p0lysim/VernierThrottle/hardware/3mf/Vernier_Throttle_Bambu_P2S.3mf

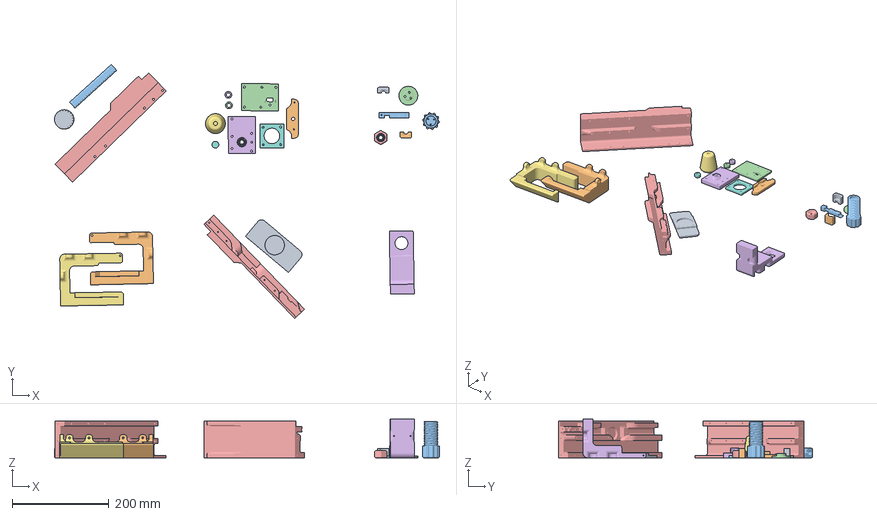
[picture p39: CAD file, 2026-11-11]
hardware/3mf/Vernier_Throttle_Bambu_P2S.3mf
794.5 x 524.5 x 79.8 mm
AS5600_Holder_P1_x1.stl
AS5600_Holder_P2_x1.stl
Arduino_Rail_x1.stl
Back_Plate_x1.stl
Bottom_Shell_x1.stl
Clamp_Center_x1.stl
Clamp_Left_x1.stl
Clamp_Pad_Cover_x1.stl
Clamp_Pad_x1.stl
Clamp_Right_x1.stl
Clamp_Screw_x1.stl
Clamp_Swivel_Disc_x1.stl
Front_Nut_x1.stl
Front_Plate_x1.stl
Knob_x1.stl
Magnet_End_Cap_x1.stl
Pinion_Gear_x1.stl
Pot_Bracket_x1.stl
Rack_Slider_x1.stl
Shaft_Collar_x2.stl x 2
Top_Shell_x1.stl
