p0lysim/VernierThrottle/hardware/stl/Pot_Bracket_x1.stl

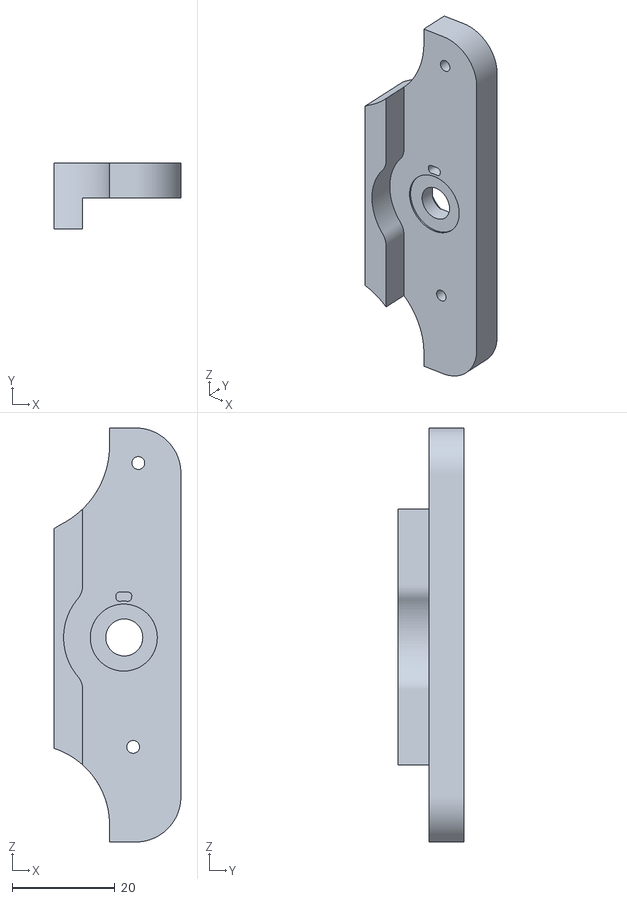
[picture p40: CAD file, 2026-11-10]
hardware/stl/Pot_Bracket_x1.stl
24.7 x 12.9 x 80.6
