p0lysim/VernierThrottle/hardware/stl/Shaft_Collar_x2.stl

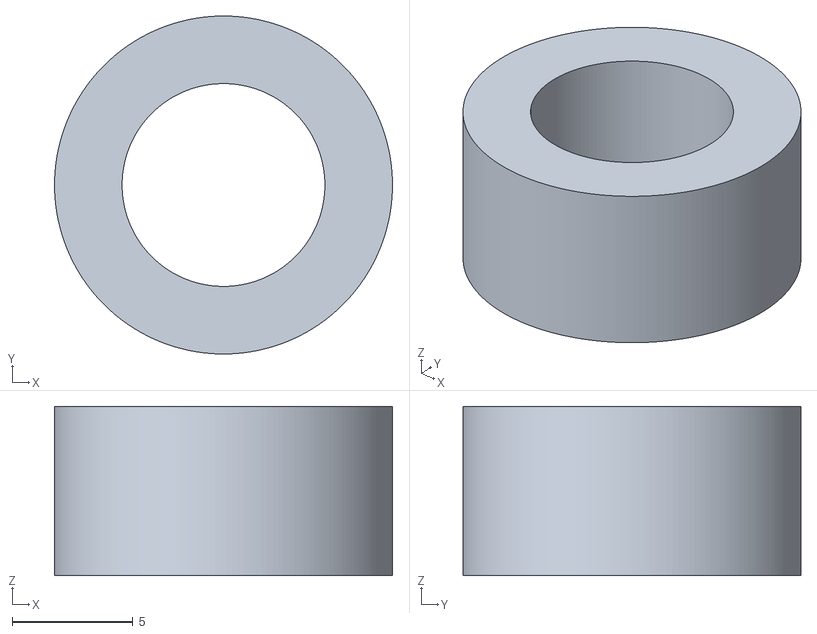
[picture p41: CAD file, 2026-11-10]
hardware/stl/Shaft_Collar_x2.stl
14.0 x 14.0 x 7.00
