p0lysim/VernierThrottle/hardware/stl/Arduino_Rail_x1.stl

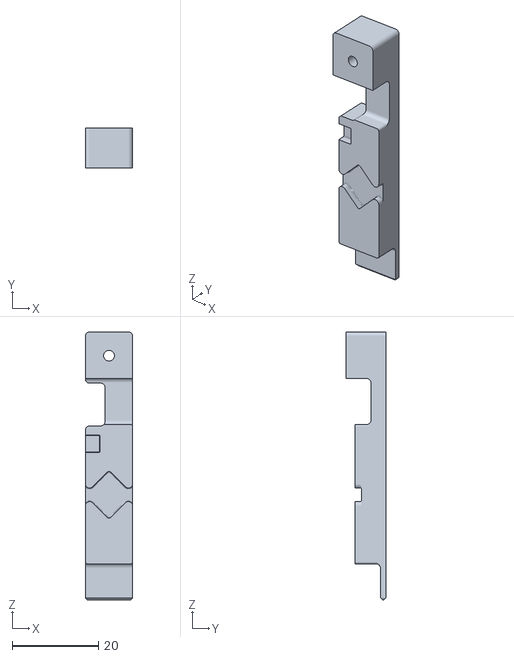
[picture p42: CAD file, 2026-11-10]
hardware/stl/Arduino_Rail_x1.stl
11.0 x 9.29 x 62.3
