p0lysim/VernierThrottle/hardware/stl/Magnet_End_Cap_x1.stl

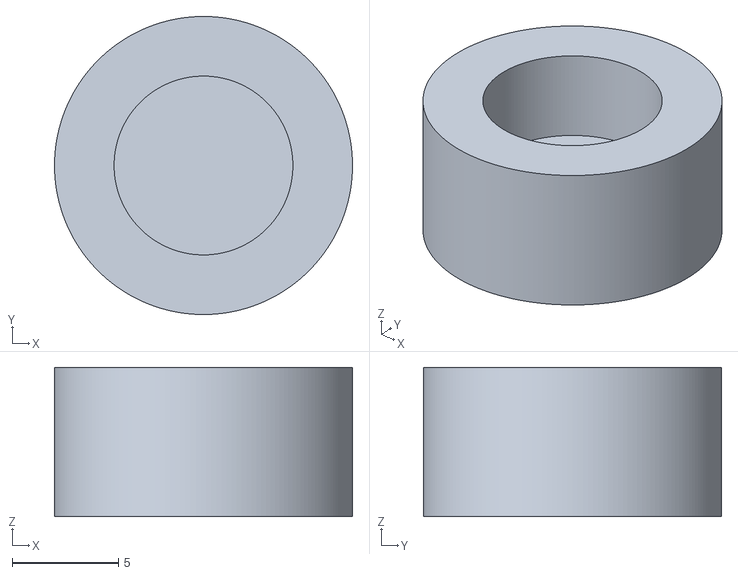
[picture p43: CAD file, 2026-11-10]
hardware/stl/Magnet_End_Cap_x1.stl
14.0 x 14.0 x 7.00
