p0lysim/VernierThrottle/hardware/stl/Clamp_Pad_x1.stl

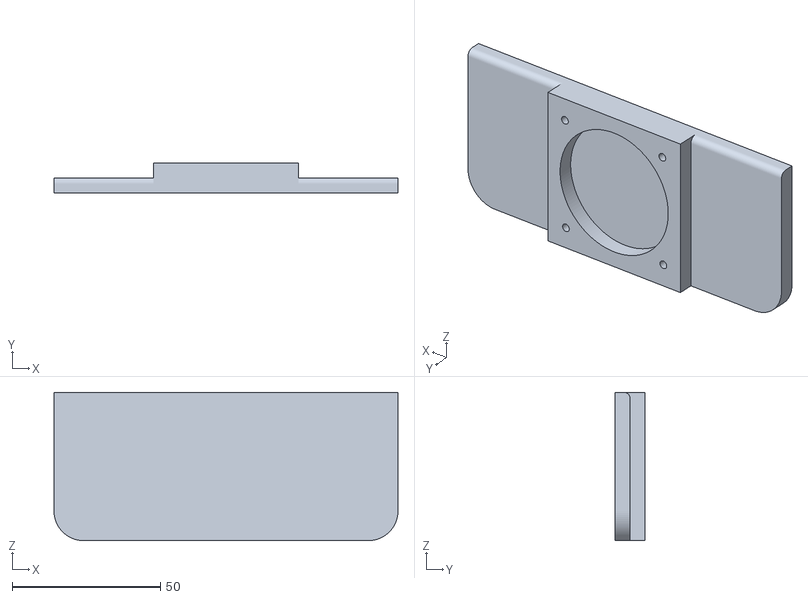
[picture p44: CAD file, 2026-11-10]
hardware/stl/Clamp_Pad_x1.stl
116.0 x 10.0 x 50.0
