p0lysim/VernierThrottle/hardware/stl/Back_Plate_x1.stl

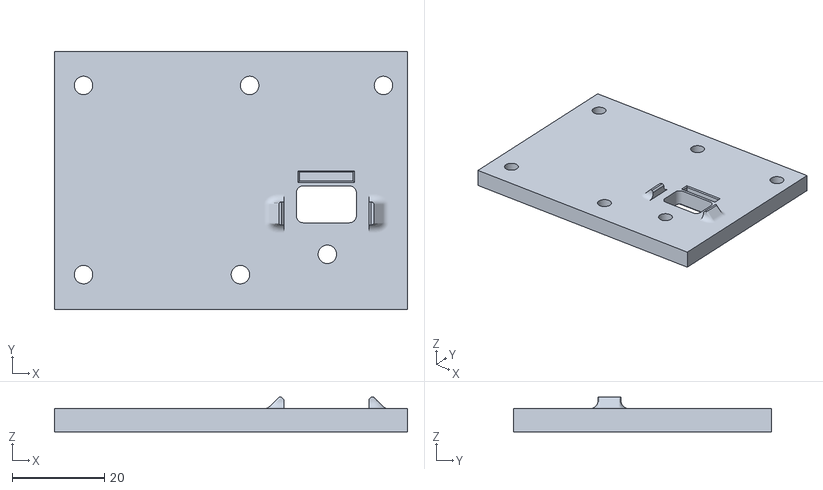
[picture p45: CAD file, 2026-11-10]
hardware/stl/Back_Plate_x1.stl
76.5 x 56.0 x 7.50
