p0lysim/VernierThrottle/hardware/stl/Clamp_Swivel_Disc_x1.stl

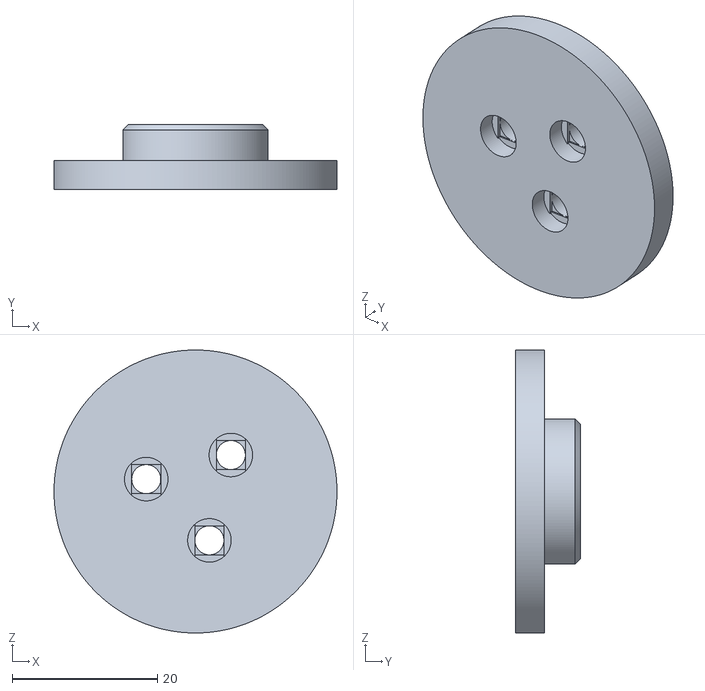
[picture p46: CAD file, 2026-11-10]
hardware/stl/Clamp_Swivel_Disc_x1.stl
39.0 x 9.00 x 39.0
