p0lysim/VernierThrottle/hardware/stl/Clamp_Right_x1.stl

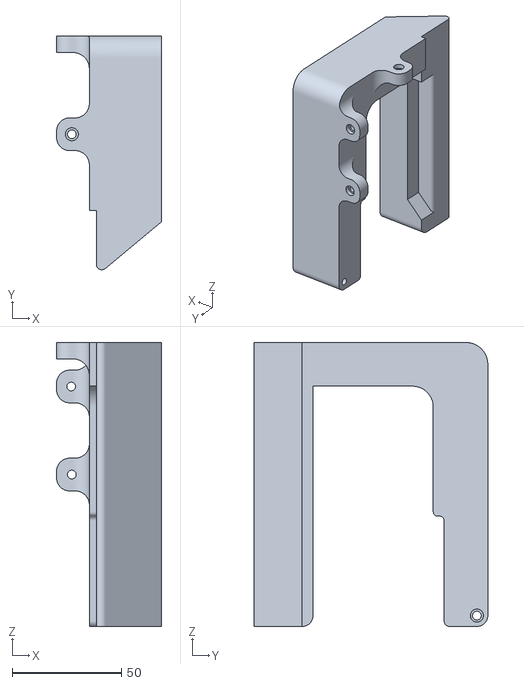
[picture p47: CAD file, 2026-11-10]
hardware/stl/Clamp_Right_x1.stl
48.0 x 107.0 x 130.0
