p0lysim/VernierThrottle/hardware/stl/Rack_Slider_x1.stl

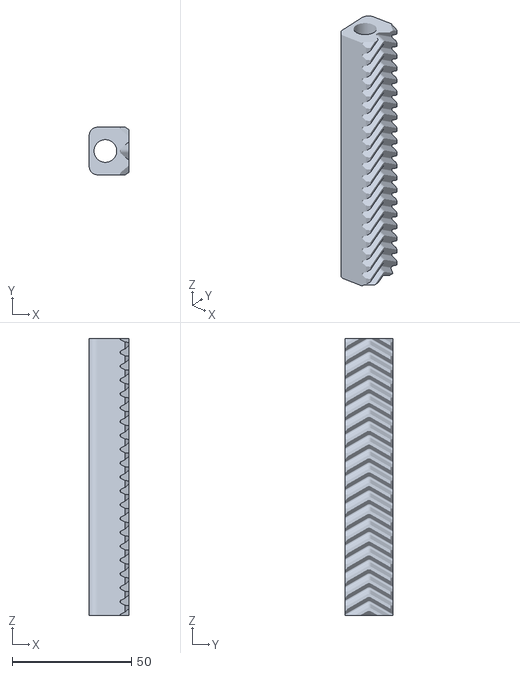
[picture p48: CAD file, 2026-11-10]
hardware/stl/Rack_Slider_x1.stl
16.6 x 20.0 x 116.1
