p0lysim/VernierThrottle/hardware/stl/Bottom_Shell_x1.stl

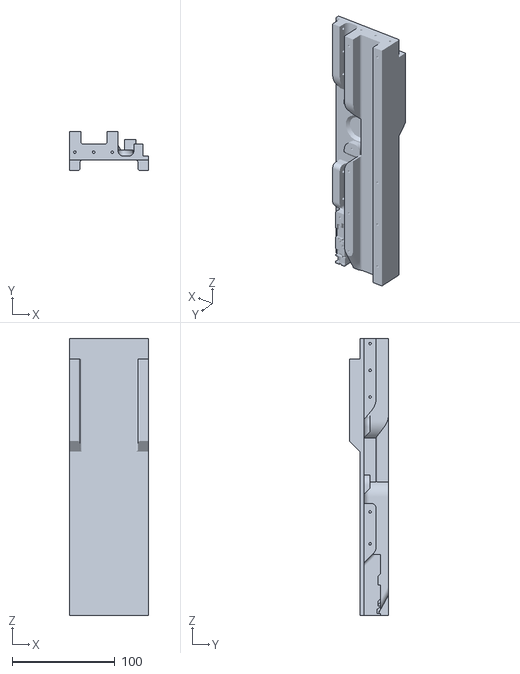
[picture p49: CAD file, 2026-11-10]
hardware/stl/Bottom_Shell_x1.stl
76.5 x 37.9 x 269.9
