p0lysim/VernierThrottle/hardware/stl/Clamp_Pad_Cover_x1.stl

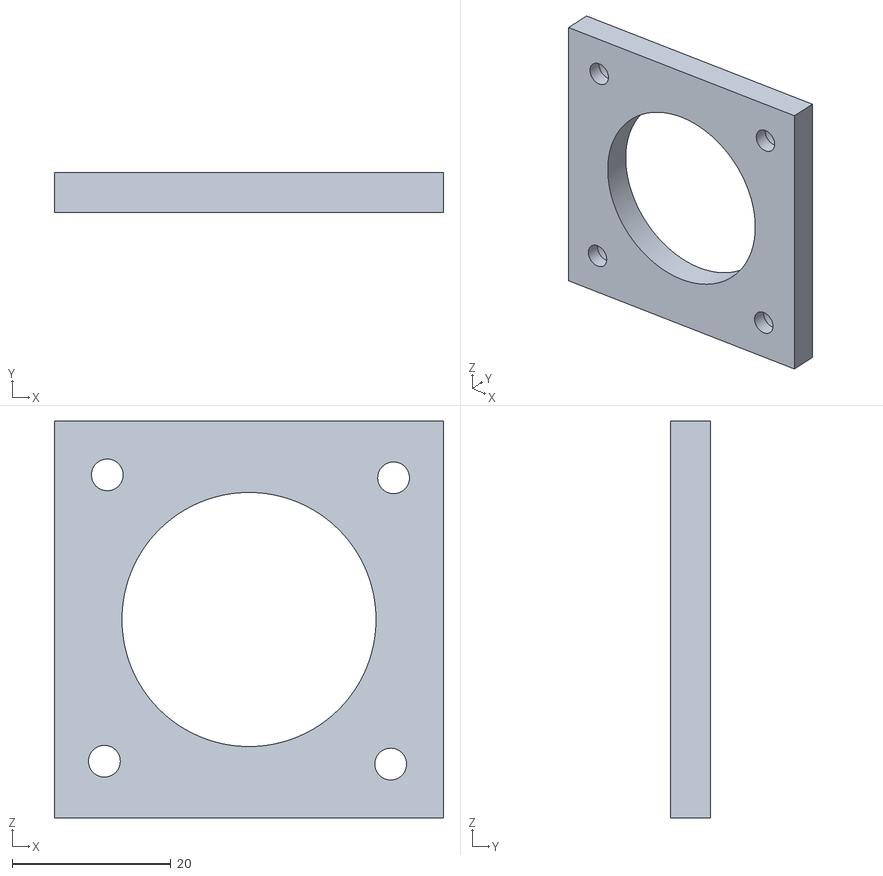
[picture p50: CAD file, 2026-11-10]
hardware/stl/Clamp_Pad_Cover_x1.stl
49.0 x 5.00 x 50.0
