p0lysim/VernierThrottle/hardware/stl/AS5600_Holder_P2_x1.stl

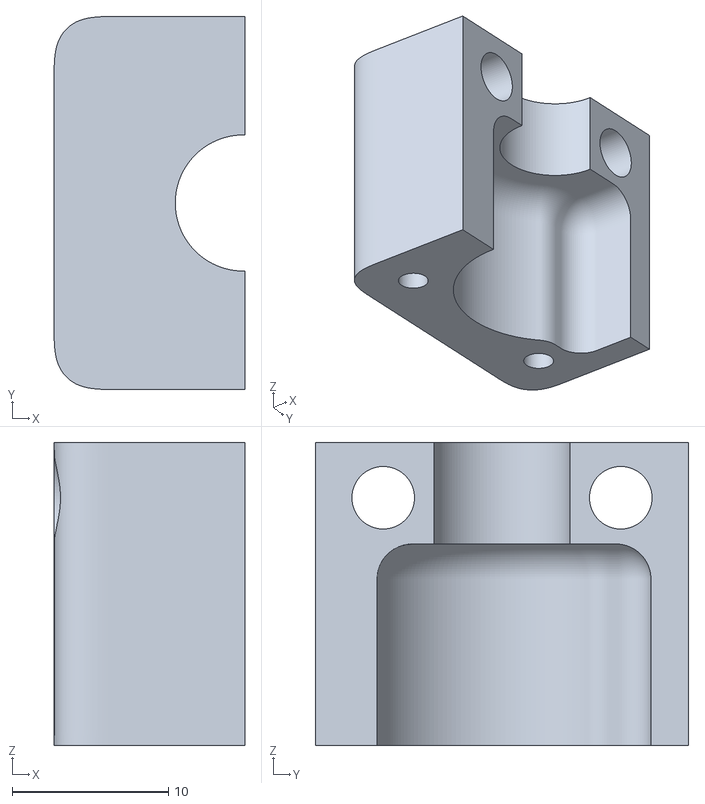
[picture p51: CAD file, 2026-11-10]
hardware/stl/AS5600_Holder_P2_x1.stl
12.2 x 23.9 x 19.4
