p0lysim/VernierThrottle/hardware/stl/Front_Plate_x1.stl

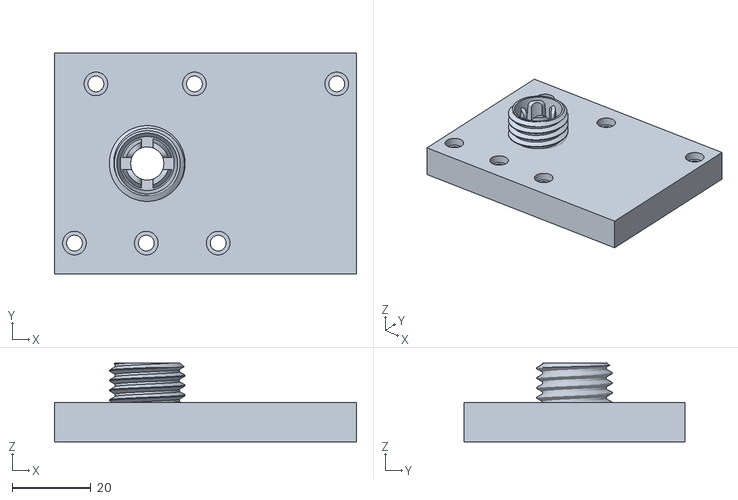
[picture p52: CAD file, 2026-11-10]
hardware/stl/Front_Plate_x1.stl
76.5 x 56.0 x 19.9
