p0lysim/VernierThrottle/hardware/stl/Knob_x1.stl

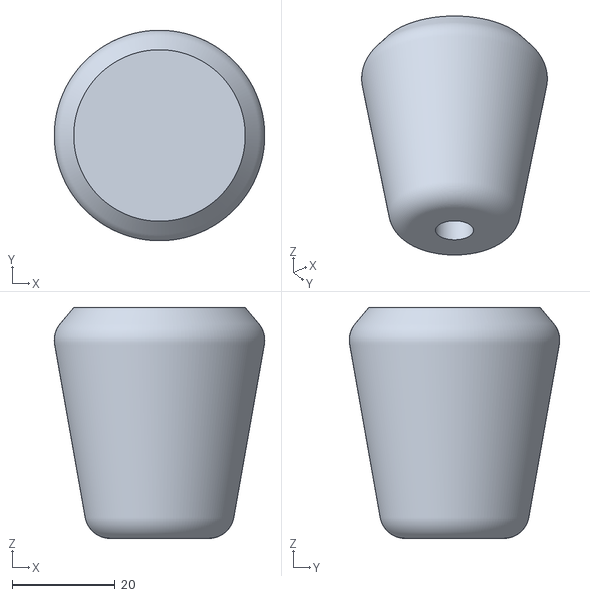
[picture p53: CAD file, 2026-11-10]
hardware/stl/Knob_x1.stl
41.0 x 41.0 x 45.0
