p0lysim/VernierThrottle/hardware/stl/Clamp_Center_x1.stl

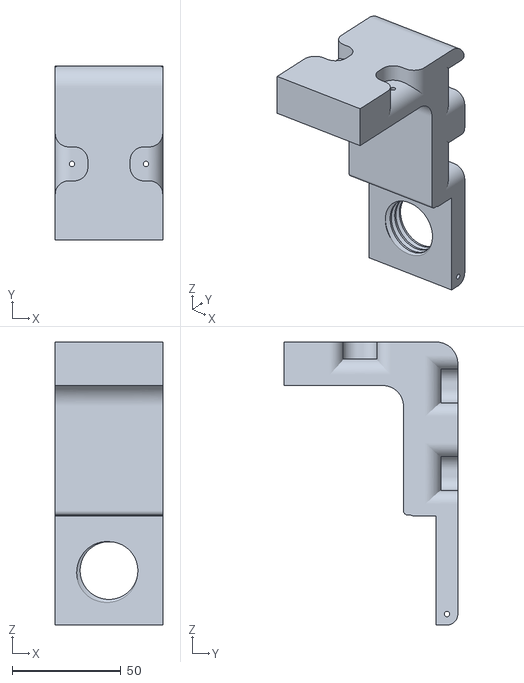
[picture p55: CAD file, 2026-11-10]
hardware/stl/Clamp_Center_x1.stl
49.4 x 79.8 x 130.0
