p0lysim/VernierThrottle/hardware/stl/Top_Shell_x1.stl

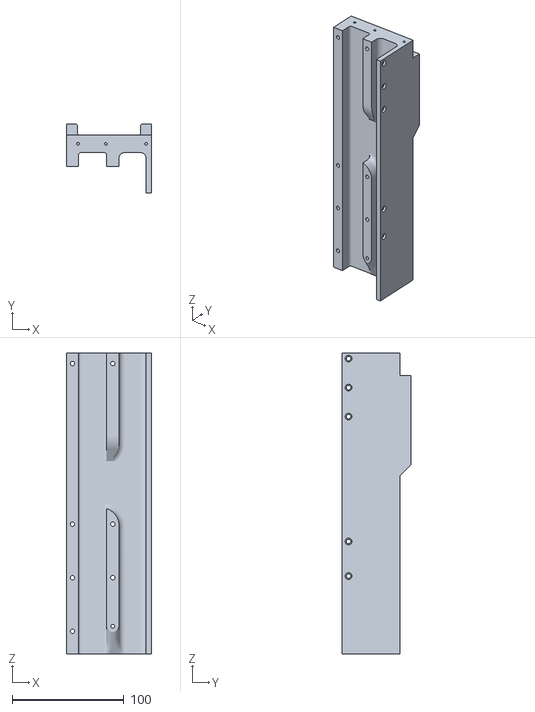
[picture p56: CAD file, 2026-11-10]
hardware/stl/Top_Shell_x1.stl
76.5 x 61.9 x 269.9
