p0lysim/VernierThrottle/hardware/stl/Pinion_Gear_x1.stl

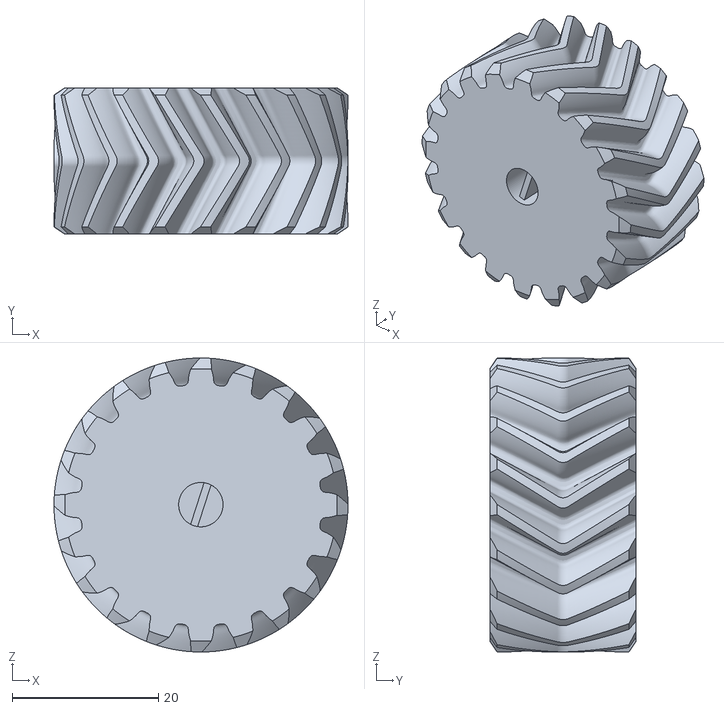
[picture p57: CAD file, 2026-11-10]
hardware/stl/Pinion_Gear_x1.stl
40.2 x 20.0 x 40.2
