p0lysim/VernierThrottle/(list of files, cad)

Other CAD files:
hardware/step/Vernier_Throttle_Support.step
hardware/step/Vernier_Throttle_V1.step
hardware/stl/Clamp_Left_x1.stl
hardware/stl/Clamp_Screw_x1.stl
hardware/stl/Front_Nut_x1.stl
