p0lysim/VernierThrottle/(commit log)

2026-11-10 Restructure repository: firmware, hardware, docs and new README
    - Move the PlatformIO project to firmware/
    - Add the 21 printable parts to hardware/stl, with English names and quantities
    - Add hardware/step and hardware/3mf folders (STEP files tracked with Git LFS)
    - New English README: highlights, specifications, bill of materials,
    illustrated assembly guide, wiring and simulator setup
    - Add docs/how-it-works.md and docs/electronics-and-firmware.md with renders
    - Licenses: CC BY-NC-SA 4.0 for hardware, MIT for firmware
    [AS5600_Holder_P1_x1.stl, AS5600_Holder_P2_x1.stl, Arduino_Rail_x1.stl, Back_Plate_x1.stl, Bottom_Shell_x1.stl, Clamp_Center_x1.stl, Clamp_Left_x1.stl, Clamp_Pad_Cover_x1.stl]
2026-11-10 Re-export parts from Fusion, add STEP files and new assembly guide
    - Re-export the 21 printable parts from the Fusion design (components V1 and support)
    - Fix the part list: one magnet end cap and two shaft collars
    - Add the STEP files of the throttle and of the desk clamp (Git LFS)
    - Show the AS5600 board and the magnet in the renders
    - Rewrite the assembly guide in 10 steps with close-up views
    - Add the how-it-works GIF animation
    [AS5600_Holder_P1_x1.stl, AS5600_Holder_P2_x1.stl, Arduino_Rail_x1.stl, Back_Plate_x1.stl, Bottom_Shell_x1.stl, Clamp_Center_x1.stl, Clamp_Left_x1.stl, Clamp_Pad_Cover_x1.stl]
2026-11-10 Shorten the README and add a wiring diagram
    - Keep three one-line highlights
    - Show only the animation and two lines in How it works
    - Remove the printing and CAD notes from the bill of materials
    - Remove the last assembly step
    - Replace the wiring table with a diagram
2026-11-10 Add the Bambu Studio project for the Bambu Lab P2S
    - 21 parts on 6 plates, 0.4 mm nozzle, 0.24 mm layers
    - Link it from the README
    [Vernier_Throttle_Bambu_P2S.3mf]
2026-11-11 Update the Bambu Studio project: add the second shaft collar
    All 22 pieces are now on the plates.
    [Vernier_Throttle_Bambu_P2S.3mf]
