p0lysim/VernierThrottle/(notices)

Notices in the files:
README.md:
Hardware license: CC BY-NC-SA 4.0
Code license: MIT
